ezuercher/TRIAC-Dimmer/README.md

# TRIAC-Dimmer
Repository containing the design files for a TRIAC dimmer.
