ezuercher/TRIAC-Dimmer/Circuit Design/Analysis/Data Comparison.xlsx

Sheet: 0k
 | t (s) | vin (V) | vout (V)
Analysis | 0.00067 | 42.48416 | 32.47614
Simulation | 0.00068 | 43.27396 | 32.30848
Experimentation

Sheet: 150k
 | Analysis |  |  | Simulation |  |  | Experimentation
 | t (ms) | vin (V) | vout (V) | t (ms) | vin (V) | vout (V) | t (ms) | vin (V) | vout (V)
Breakover 1 | 0.00472 | 166.31464 | 32.05386 | 0.00478 | 165.53881 | 32.42021
Breakover N | 0.00833333N + 0.00569 | 142.72893 | 32.03184 | 0.00833333N + 0.00575447 | 140.44385 | 32.34020

Sheet: 250k
 | Analysis |  |  | Simulation |  |  | Experimentation
 | t (ms) | vin (V) | vout (V) | t (ms) | vin (V) | vout (V) | t (ms) | vin (V) | vout (V)
Peak 1 | 0.00785 | 30.80498 | 30.74386 | 0.00783 | 31.94269 | 30.61266
Peak 2 | 0.02462 | 24.27041 | 24.47209 | 0.02462 | 24.11576 | 24.33699
Peak 3 | 0.04133 | 21.51858 | 21.24781 | 0.04129 | 24.09786 | 21.12809
Peak 4 | 0.05802 | 20.03439 | 19.58779 | 0.05806 | 17.44633 | 19.48824
Peak 5 | 0.07471 | 18.54866 | 18.73259 | 0.07467 | 21.14208 | 18.64862
Peak 6 | 0.09138 | 18.33629 | 18.29179 | 0.09139 | 17.59422 | 18.22047
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
