ezuercher/TRIAC-Dimmer/Circuit Design/Analysis/RC AC Response.xlsx

Sheet: Full Response
Vi | 170 | t | vi(t) | vo(t)
ω | 376.9911184 | 0 | 0.0000 | 3.552713679e-15
R | 201620 | 1e-05 | 0.6409 | 0.0002
C | 1e-07 | 2e-05 | 1.2818 | 0.0006
τ | 0.020162 | 3e-05 | 1.9226 | 0.0014
v(0-) | 0 | 4e-05 | 2.5634 | 0.0025
 |  | 5e-05 | 3.2042 | 0.0040
 |  | 6e-05 | 3.8450 | 0.0057
 |  | 7e-05 | 4.4857 | 0.0078
 |  | 8e-05 | 5.1263 | 0.0102
 |  | 9e-05 | 5.7669 | 0.0129
 |  | 0.0001 | 6.4073 | 0.0159
 |  | 0.00011 | 7.0477 | 0.0192
 |  | 0.00012 | 7.6880 | 0.0228
 |  | 0.00013 | 8.3282 | 0.0268
 |  | 0.00014 | 8.9682 | 0.0311
 |  | 0.00015 | 9.6082 | 0.0357
 |  | 0.00016 | 10.2479 | 0.0406
 |  | 0.00017 | 10.8876 | 0.0458
 |  | 0.00018 | 11.5271 | 0.0513
 |  | 0.00019 | 12.1664 | 0.0572
 |  | 0.0002 | 12.8056 | 0.0633
 |  | 0.00021 | 13.4445 | 0.0698
 |  | 0.00022 | 14.0833 | 0.0766
 |  | 0.00023 | 14.7219 | 0.0837
 |  | 0.00024 | 15.3603 | 0.0911
 |  | 0.00025 | 15.9984 | 0.0989
 |  | 0.00026 | 16.6363 | 0.1069
 |  | 0.00027 | 17.2740 | 0.1152
 |  | 0.00028 | 17.9115 | 0.1239
 |  | 0.00029 | 18.5487 | 0.1329
 |  | 0.0003 | 19.1856 | 0.1422
 |  | 0.00031 | 19.8222 | 0.1518
 |  | 0.00032 | 20.4586 | 0.1617
 |  | 0.00033 | 21.0947 | 0.1719
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
