ezuercher/TRIAC-Dimmer/Documents/Analytical Model 2.png

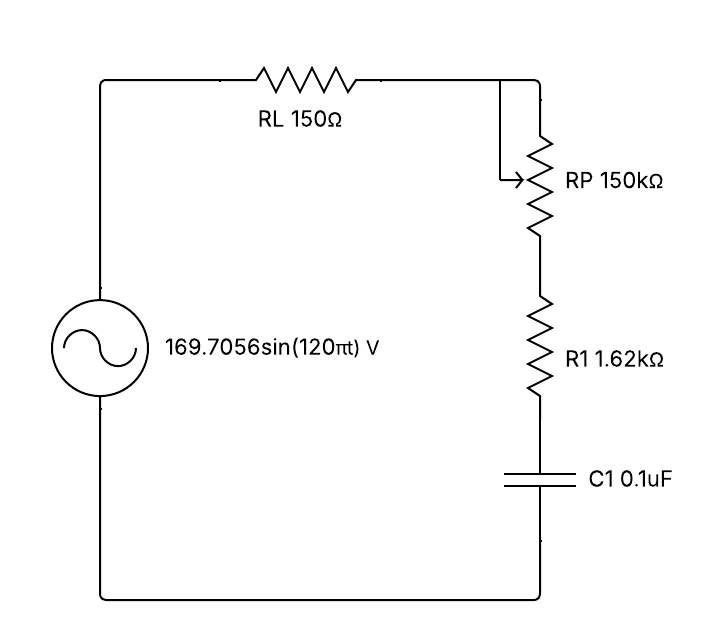
Documents/Analytical Model 2.png
