ezuercher/TRIAC-Dimmer/Circuit Design/BOM.xlsx

id. | val. | man. pn.
R1 | 1.62 kΩ | RNF14FTD1K62 (https://www.digikey.com/en/products/detail/stackpole-electronics-inc/RNF14FTD1K62/1709707)
R2 | 332 kΩ | RNF14FTD332K (https://www.digikey.com/en/products/detail/stackpole-electronics-inc/RNF14FTD332K/1682204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)
P1 | 500 kΩ | PTV09A-2020F-B504 (https://www.digikey.com/en/products/detail/bourns-inc/PTV09A-2020F-B504/6153481)
C1 | 100 nF | B32672L6104K000 (https://www.digikey.com/en/products/detail/epcos-tdk-electronics/B32672L6104K000/6160013)
Q1 |  | BTB04-600SL (https://www.digikey.com/en/products/detail/stmicroelectronics/BTB04-600SL/1037723)
Q2 |  | DB3 (https://www.digikey.com/en/products/detail/stmicroelectronics/DB3/610327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)
CN1, CN2 |  | 1726480102 (https://www.digikey.com/en/products/detail/molex/1726480102/9352770)
Knob |  | CL172976 (https://www.digikey.com/en/products/detail/cliff-electronic-components-ltd/CL172976/21361122)
F1 | 3.5A | 023403.5MXP (https://www.digikey.com/en/products/detail/littelfuse-inc/023403-5MXP/778094)
F1 Holder |  | 05200101Z (https://www.digikey.com/en/products/detail/littelfuse-inc/05200101Z/554336)
TP1, TP2, TP3 |  | 5271 (https://www.digikey.com/en/products/detail/keystone-electronics/5271/12751683)
