ezuercher/TRIAC-Dimmer/Circuit Design/KiCad/TRIAC_Dimmer/3dmodels/TO-220AB_STM.step

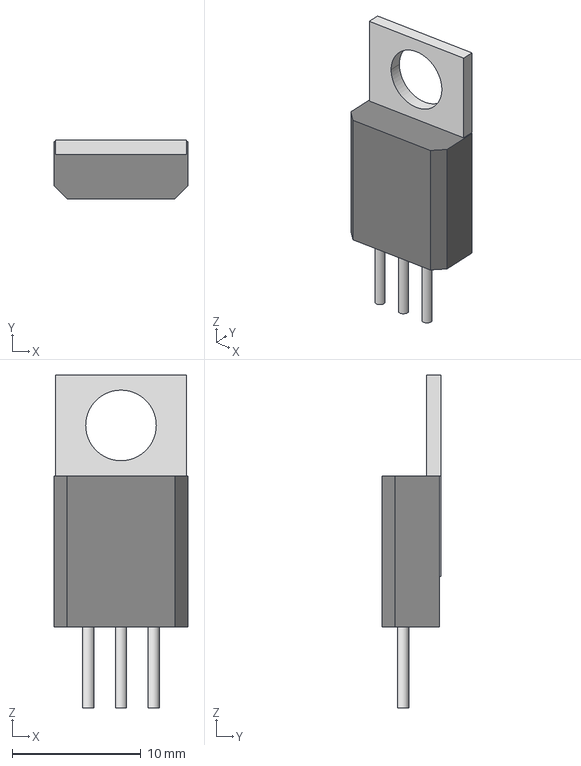
[picture p4: CAD file, 2025-08-25]
Circuit Design/KiCad/TRIAC_Dimmer/3dmodels/TO-220AB_STM.step
10.4 x 4.60 x 25.9 mm
