ezuercher/TRIAC-Dimmer/Circuit Design/KiCad/TRIAC_Dimmer/3dmodels/FUSE_05200101Z_LTF.step

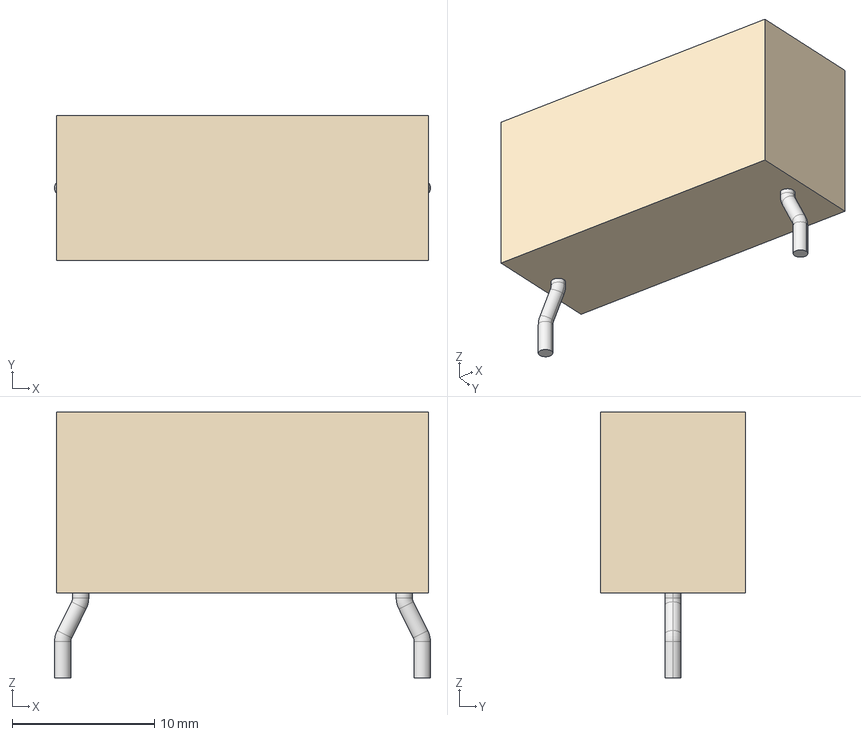
[picture p5: CAD file, 2025-08-25]
Circuit Design/KiCad/TRIAC_Dimmer/3dmodels/FUSE_05200101Z_LTF.step
26.4 x 10.2 x 18.7 mm
