ezuercher/TRIAC-Dimmer/Circuit Design/KiCad/TRIAC_Dimmer/3dmodels/5271.step

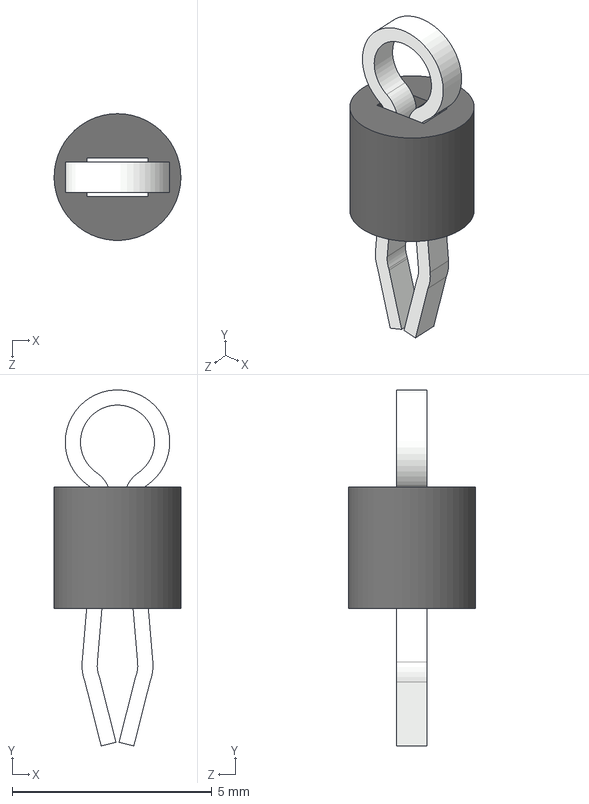
[picture p6: CAD file, 2025-08-25]
Circuit Design/KiCad/TRIAC_Dimmer/3dmodels/5271.step
3.17 x 8.91 x 3.17 mm
