ezuercher/TRIAC-Dimmer/Circuit Design/KiCad/TRIAC_Dimmer/3dmodels/B32672L6104K000.step

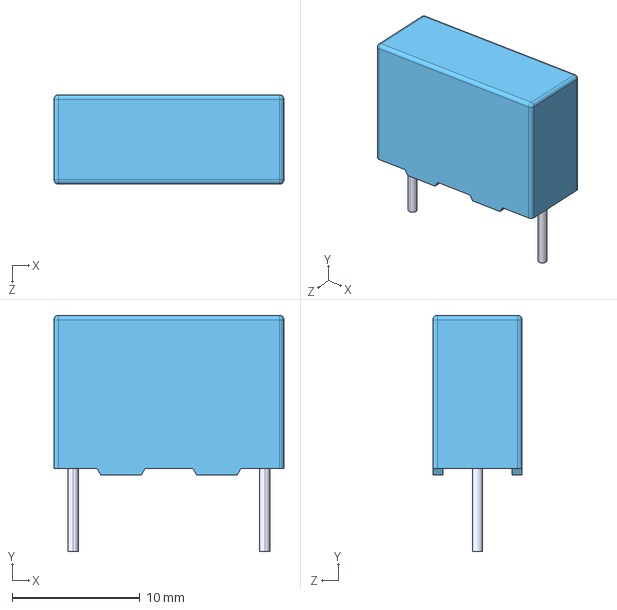
[picture p7: CAD file, 2025-08-25]
Circuit Design/KiCad/TRIAC_Dimmer/3dmodels/B32672L6104K000.step
18.0 x 18.5 x 7.00 mm
