ezuercher/TRIAC-Dimmer/(list of files, drawings)

Other design files:
Circuit Design/PSPICE/TRIAC DIMMER.DSN
Circuit Design/PSPICE/TRIAC Dimmer.opj
