ezuercher/TRIAC-Dimmer/Circuit Design/KiCad/TRIAC_Dimmer/TRIAC_Dimmer.kicad_pcb

## KiCad design Circuit Design/KiCad/TRIAC_Dimmer/TRIAC_Dimmer.kicad_pcb (2025-08-29)

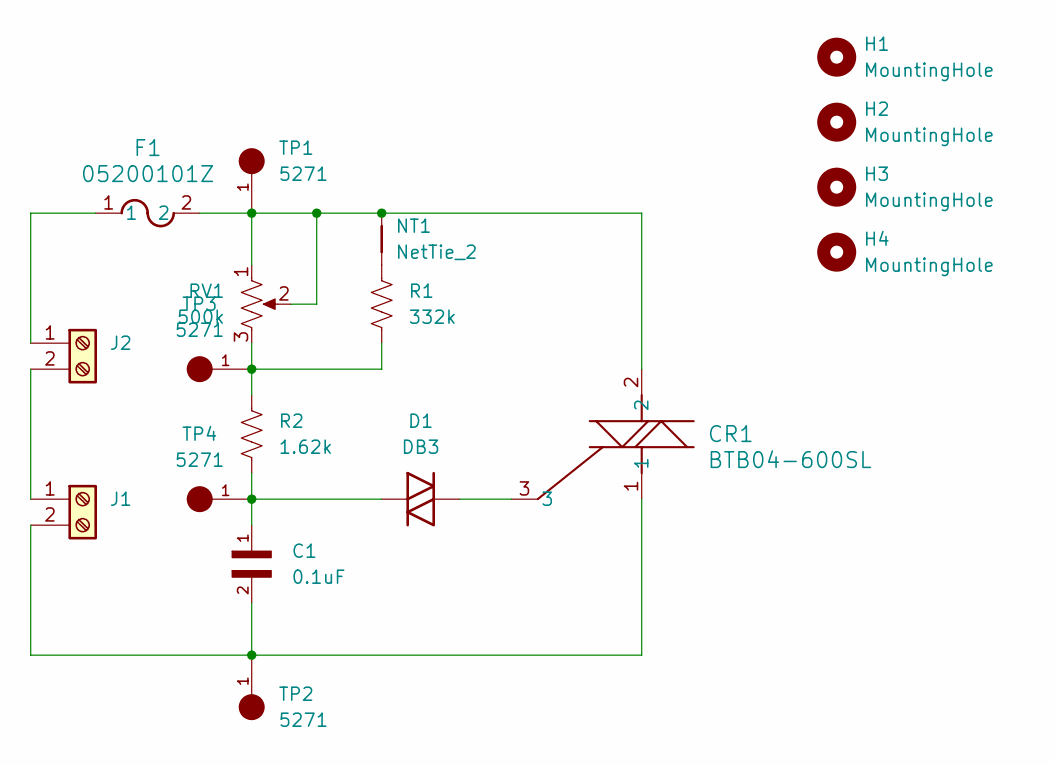
[picture p8: schematic TRIAC_Dimmer.kicad_sch, TRIAC Dimmer]

Parts:
C1: 0.1uF; CAPRR1500W80L1800T700H1250; PARTREV 2020-06
CR1: BTB04-600SL; TO-220AB_STM
D1: DB3; D_DO-35_SOD27_P7.62mm_Horizontal
F1: 05200101Z; FUSE_05200101Z_LTF
H1, H2, H3, H4: MountingHole; MountingHole_3.2mm_M3
J1, J2: Screw_Terminal_01x02; TerminalBlock_Phoenix_MKDS-1,5-2-5.08_1x02_P5.08mm_Horizont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
NT1: NetTie_2; NetTie-2_SMD_Pad0.5mm
R1: 332k; R_Axial_DIN0207_L6.3mm_D2.5mm_P7.62mm_Horizontal
R2: 1.62k; R_Axial_DIN0207_L6.3mm_D2.5mm_P7.62mm_Horizontal
RV1: 500k; Potentiometer_Bourns_PTV09A-2_Single_Horizontal
TP1, TP2, TP3, TP4: 5271; KEYSTONE_5271

Connections:
unnamed: CR1.2, F1.2, NT1.2, RV1.1, RV1.2, TP1.1
unnamed: CR1.3, D1.2 (A)
unnamed: C1.1, D1.1 (K), R2.2, TP4.1
unnamed: J1.1, J2.2
unnamed: C1.2, CR1.1, J1.2, TP2.1
unnamed: F1.1, J2.1
unnamed: NT1.1, R1.1
unnamed: R1.2, R2.1, RV1.3, TP3.1

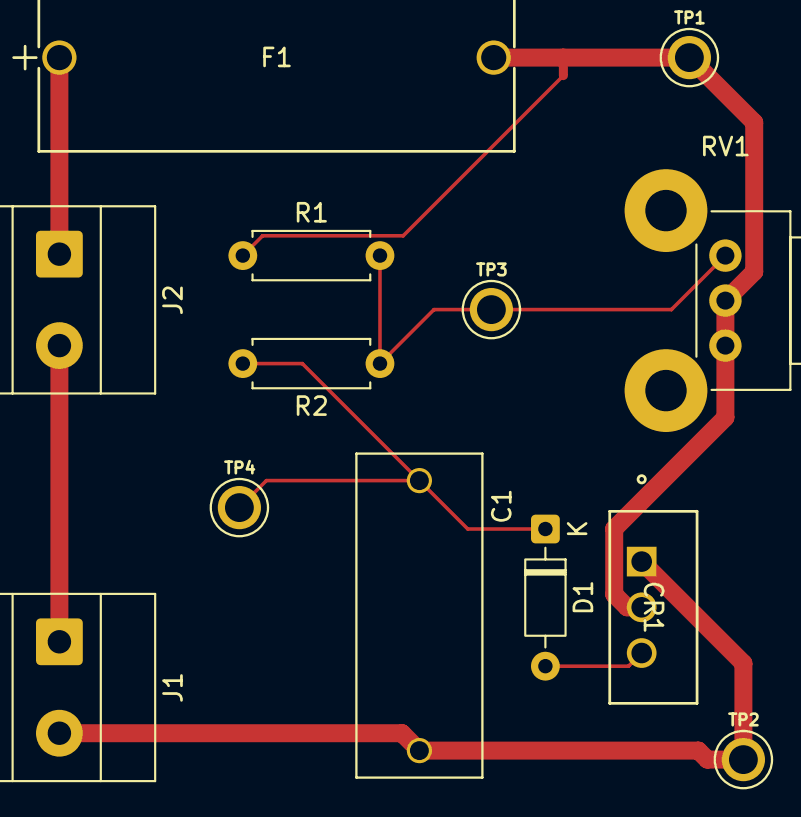
[picture p9: board TRIAC_Dimmer.kicad_pcb from above]

Board: 2 copper layers, 18 parts (0 on the bottom side), 8 nets.
