ezuercher/TRIAC-Dimmer/Circuit Design/Analysis/Voltage Simulation Results.xlsx

Sheet: 0k
t | vi(t) | vo(t)
0.00000000 | 0.0000 | 2.851990931e-22 | To collect this data, the potentiometer was set to 0k.
0.00000100 | 0.0641 | 0.0004
0.00000108 | 0.0695 | 0.0004
0.00000125 | 0.0803 | 0.0005
0.00000159 | 0.1019 | 0.0006
0.00000226 | 0.1451 | 0.0011
0.00000361 | 0.2314 | 0.0025
0.00000631 | 0.4042 | 0.0073
0.00000908 | 0.5821 | 0.0148
0.00001332 | 0.8535 | 0.0314
0.00001793 | 1.1494 | 0.0563
0.00002717 | 1.7412 | 0.1268
0.00004564 | 2.9247 | 0.3451
0.00006879 | 4.4085 | 0.7496
0.00011511 | 7.3748 | 1.9361
0.00020774 | 13.2998 | 5.4107
0.00030774 | 19.6781 | 10.2740
0.00032024 | 20.4736 | 10.9394
0.00034524 | 22.0632 | 12.2952
0.00035149 | 22.4603 | 12.6392
0.00036399 | 23.2541 | 13.3326
0.00036711 | 23.4525 | 13.5070
0.00037336 | 23.8492 | 13.8571
0.00038586 | 24.6421 | 14.5619
0.00041086 | 26.2263 | 15.9885
0.00046086 | 29.3875 | 18.8979
0.00056086 | 35.6775 | 24.8712
0.00066086 | 41.9167 | 30.9664
0.00067336 | 42.6927 | 31.7331
0.00067649 | 42.8865 | 31.9249
0.00068274 | 43.2740 | 32.3085
0.00068430 | 43.3708 | 32.4044
0.00068742 | 43.5644 | 32.5962
0.00068820 | 43.6128 | 32.6442
0.00068931 | 43.6815 | 32.7123
0.00069013 | 43.7319 | 32.7621
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
