ezuercher/TRIAC-Dimmer/Circuit Design/Analysis/Current Simulation Results.xlsx

Sheet: 0k
t | il(t) | irc(t)
0.00000000 | 1.140243363e-25 | 1.140243893e-25
0.00000100 | 3.640266507e-05 | 3.596817476e-05
0.00000108 | 3.946157919e-05 | 3.899711618e-05
0.00000125 | 4.556499817e-05 | 4.505295756e-05
0.00000159 | 0.0001 | 0.0001
0.00000226 | 0.0001 | 0.0001
0.00000361 | 0.0001 | 0.0001
0.00000631 | 0.0002 | 0.0002
0.00000908 | 0.0003 | 0.0003
0.00001332 | 0.0005 | 0.0005
0.00001793 | 0.0006 | 0.0006
0.00002717 | 0.0009 | 0.0009
0.00004564 | 0.0015 | 0.0015
0.00006879 | 0.0021 | 0.0021
0.00011511 | 0.0032 | 0.0031
0.00020774 | 0.0046 | 0.0044
0.00030774 | 0.0056 | 0.0053
0.00032024 | 0.0056 | 0.0054
0.00034524 | 0.0058 | 0.0055
0.00035149 | 0.0058 | 0.0055
0.00036399 | 0.0059 | 0.0056
0.00036711 | 0.0059 | 0.0056
0.00037336 | 0.0059 | 0.0056
0.00038586 | 0.0060 | 0.0057
0.00041086 | 0.0061 | 0.0058
0.00046086 | 0.0063 | 0.0059
0.00056086 | 0.0066 | 0.0061
0.00066086 | 0.0067 | 0.0061
0.00067336 | 0.0067 | 0.0061
0.00067649 | 0.0067 | 0.0061
0.00068274 | 0.0067 | 0.0061
0.00068430 | 0.0067 | 0.0061
0.00068742 | 0.0067 | 0.0061
0.00068820 | 0.0067 | 0.0061
0.00068931 | 0.0067 | 0.0061
0.00069013 | 0.0067 | 0.0061
0.00069022 | 0.0067 | 0.0061
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
