ezuercher/TRIAC-Dimmer/(commit log)

2025-08-20 Finished analytical portion of report
    [BOM.xlsx]
2025-08-20 Working on documenting simulation results
    [RC AC Response.xlsx, TRIAC DIMMER.DSN, TRIAC Dimmer.opj, Voltage Simulation Results.xlsx]
2025-08-22 Filling out simulation section of report
    [Data Comparison.xlsx, RC AC Response.xlsx, Voltage Simulation Results.xlsx]
2025-08-22 Finished simulation portion of report
    [Data Comparison.xlsx, RC AC Response.xlsx, TRIAC DIMMER.DSN]
2025-08-25 PCB libraries were global, made them local
    [5271.step, B32672L6104K000.step, BOM.xlsx, FUSE_05200101Z_LTF.step, TO-220AB_STM.step, TRIAC DIMMER.DSN, TRIAC Dimmer.opj, TRIAC_Dimmer.kicad_pcb]
2025-08-25 Was going to build cable, now going with screw terminals
    [BOM.xlsx]
2025-08-29 Rough layout complete
    [TRIAC_Dimmer.kicad_pcb, TRIAC_Dimmer.kicad_sch]
